WoodrowRobocats/PiArcade/README.md

# PiArcade
Raspberry Pi based desktop arcade game
