WoodrowRobocats/PiArcade/PiArcade.bmp

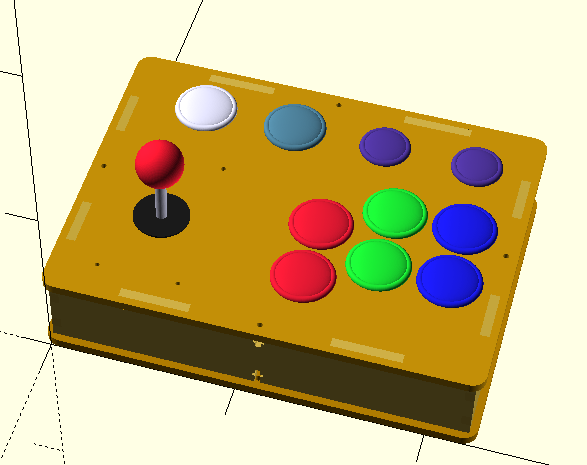
PiArcade.bmp
