WoodrowRobocats/PiArcade/PiArcadePCBImage.bmp

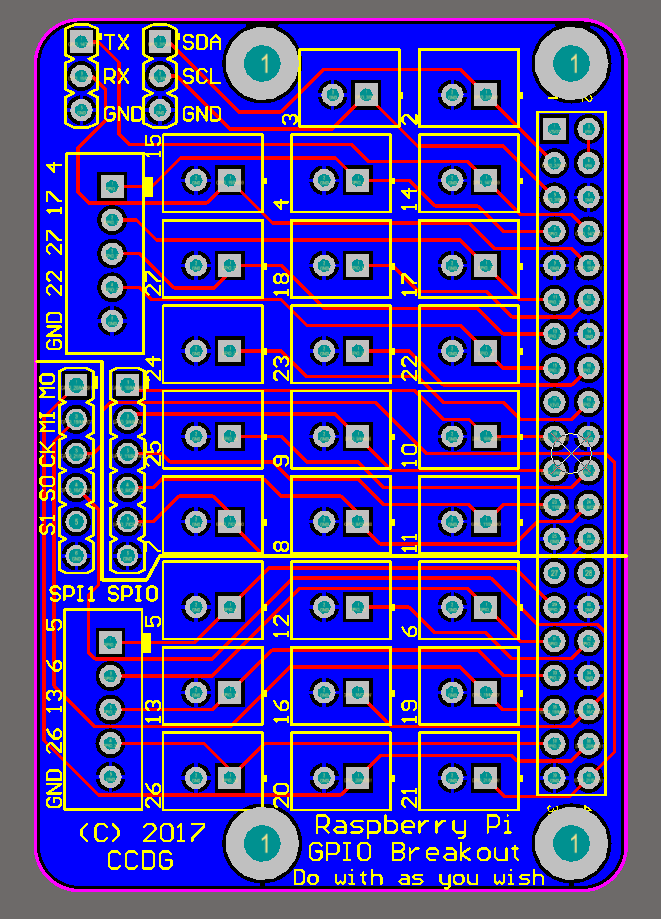
PiArcadePCBImage.bmp
