WoodrowRobocats/PiArcade/PicadeCase.dxf

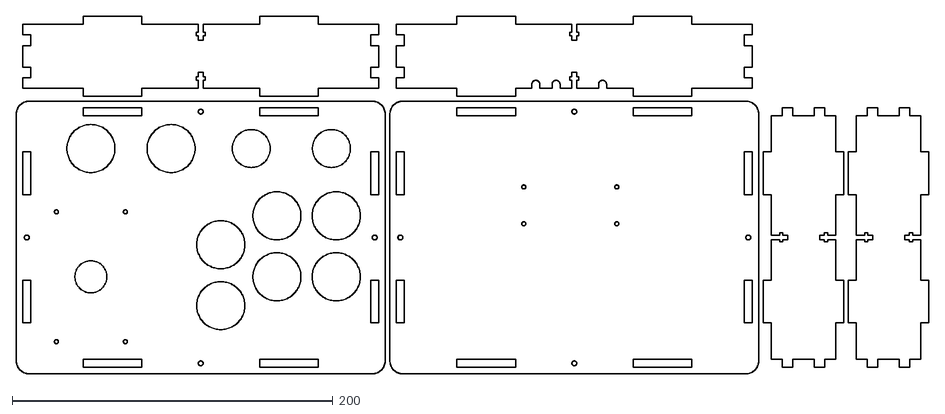
[picture p3: CAD file, 2018-03-26]
PicadeCase.dxf
569.0 x 223.0
