WoodrowRobocats/PiArcade/PrintPiZeroMountPlate.stl

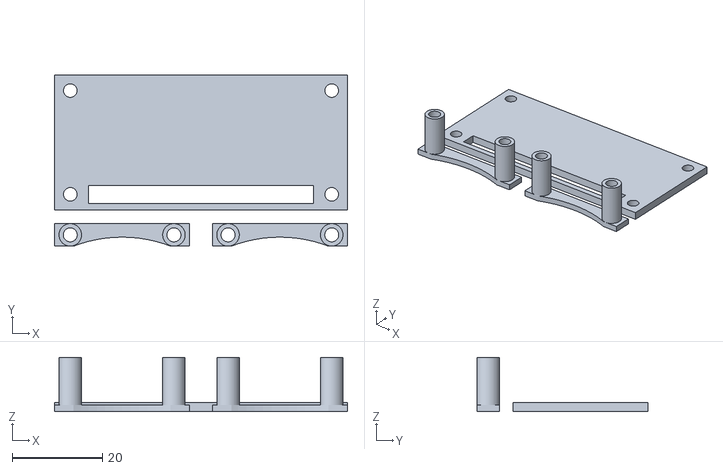
[picture p4: CAD file, 2018-03-26]
PrintPiZeroMountPlate.stl
65.0 x 38.0 x 12.0
