WoodrowRobocats/PiArcade/PicadeCaseTopProtector.dxf

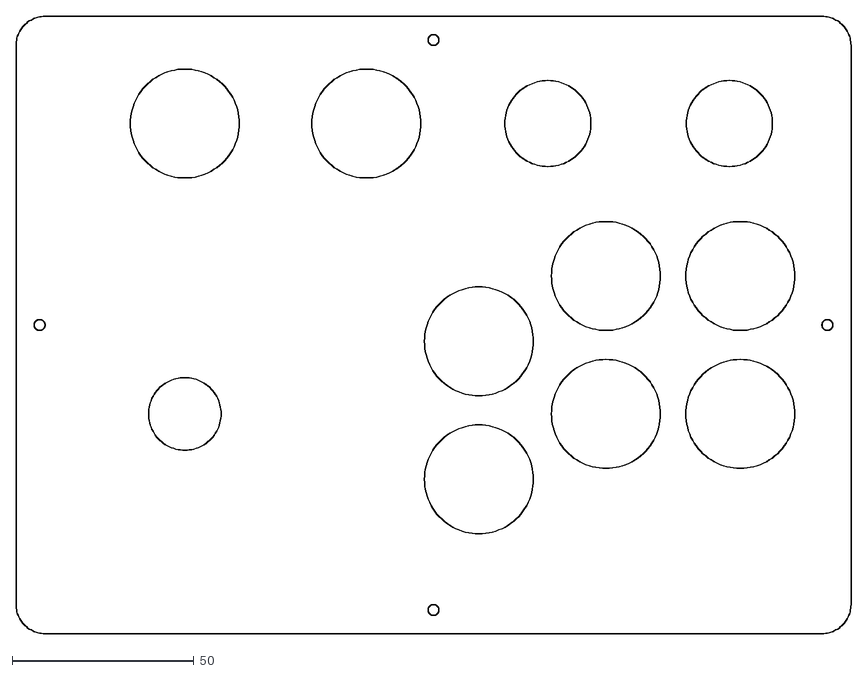
[picture p5: CAD file, 2018-03-26]
PicadeCaseTopProtector.dxf
230.0 x 170.0
