WoodrowRobocats/PiArcade/PiArcadeGPIO.pdf

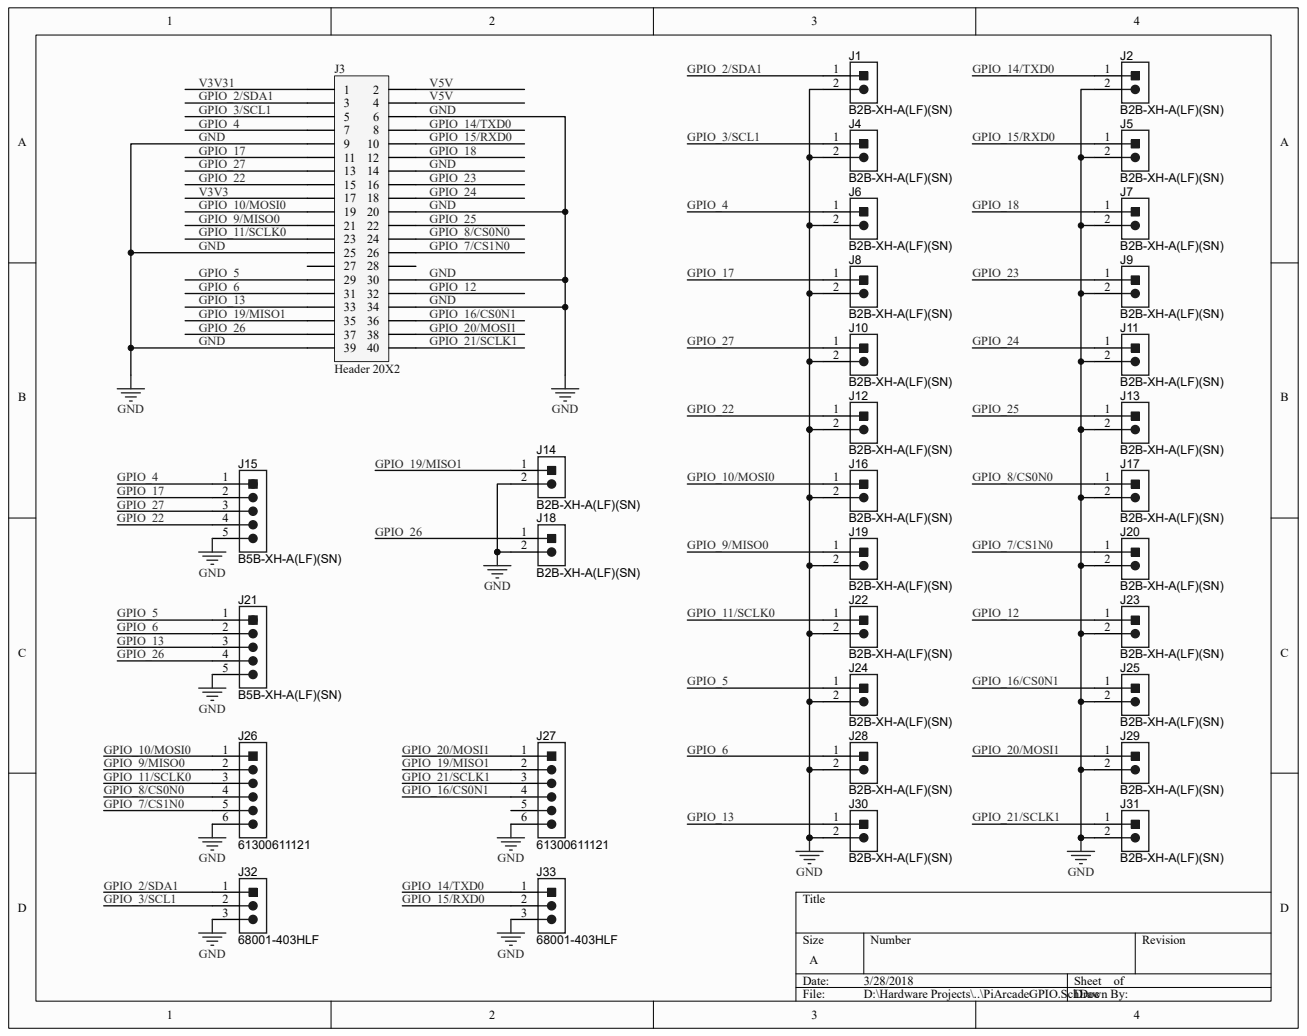
[picture p6: page 1]
