WoodrowRobocats/PiArcade/PrintPiZeroMountPlate.bmp

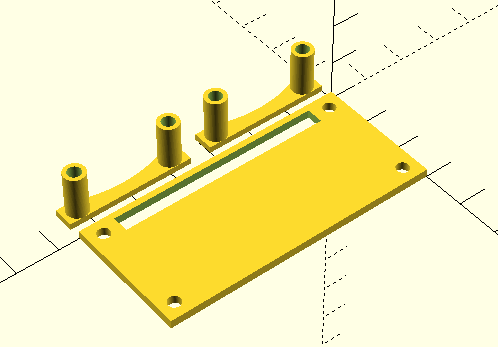
PrintPiZeroMountPlate.bmp
